Lambali/FET-MATCHER/fetM1.jpeg

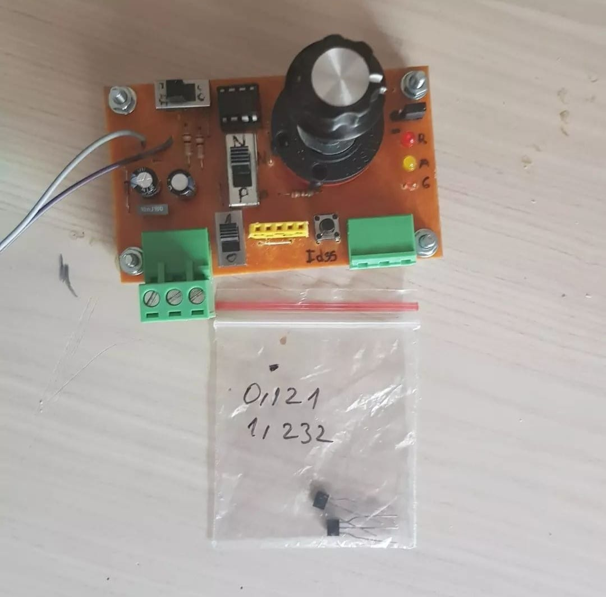
fetM1.jpeg
