Lambali/FET-MATCHER/fetM2.jpeg

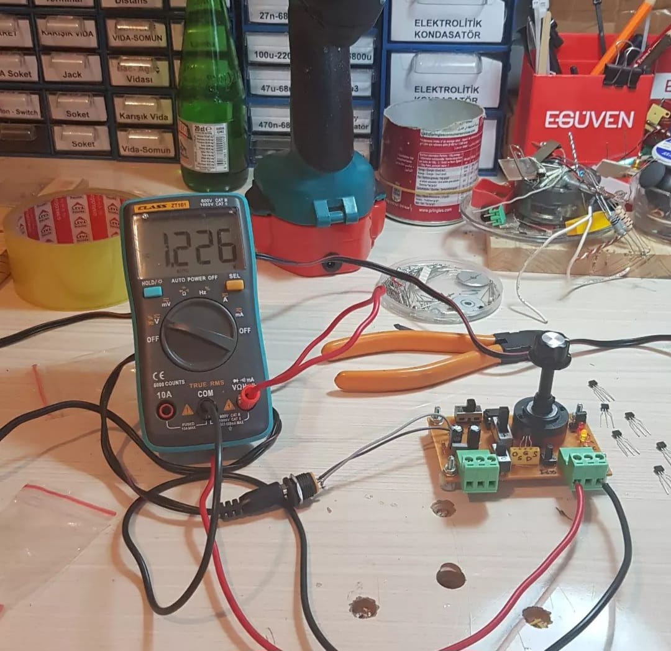
fetM2.jpeg
