Lambali/FET-MATCHER/sema.png

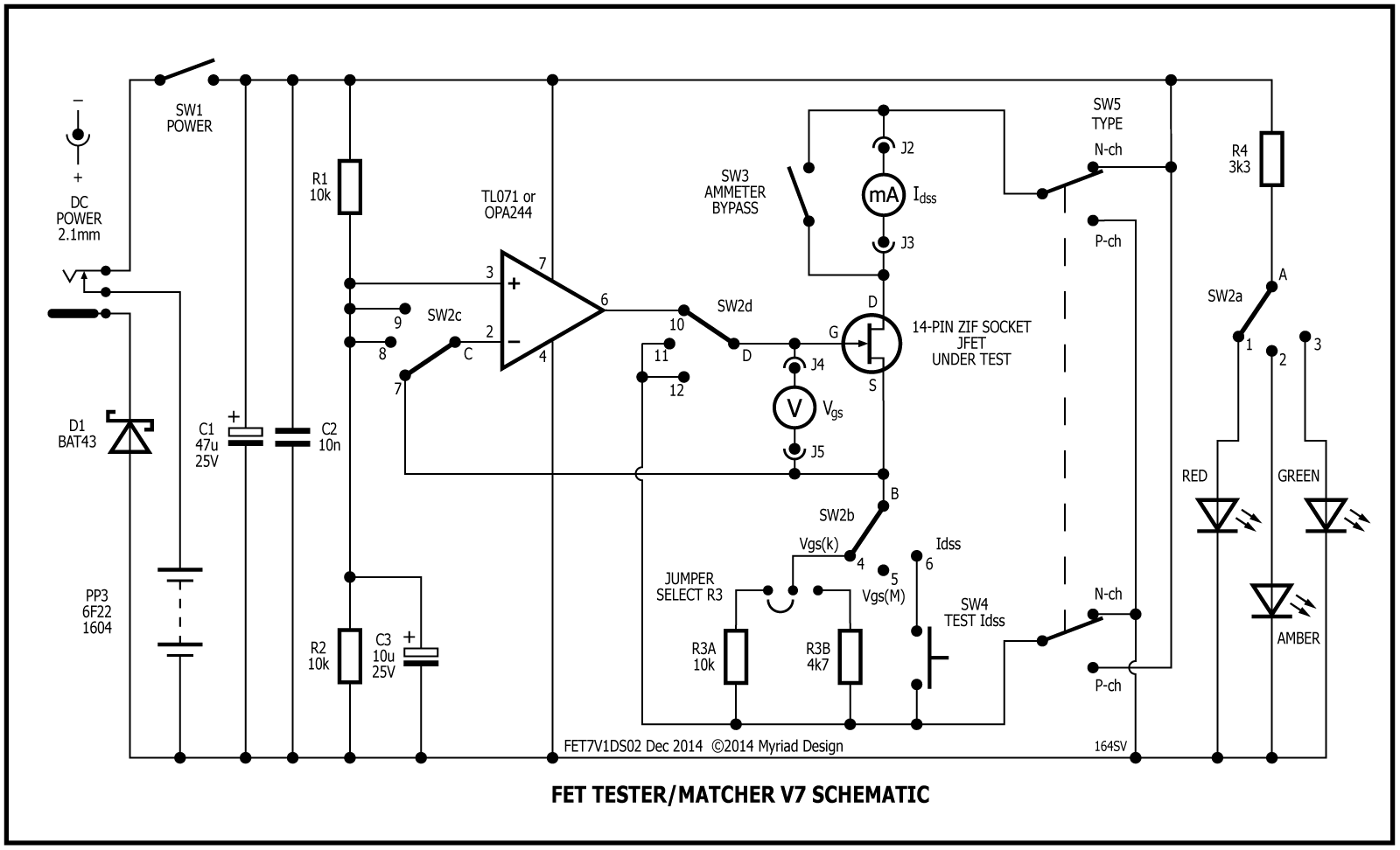
sema.png
