Lambali/FET-MATCHER/(list of files, drawings)

Other design files:
FetMatcher6.DSN
FetMatcher6.LYT
